nm47/blup/CAD/reference/blup-pcb-completed.step

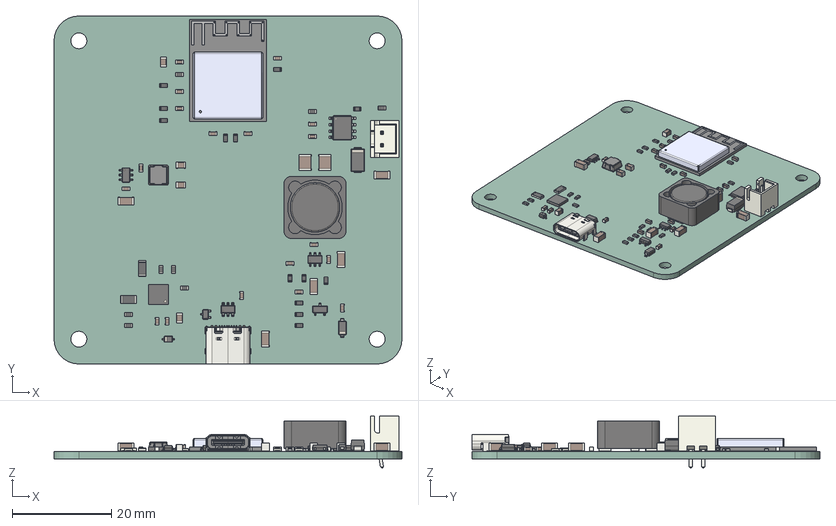
[picture p1: CAD file, 2026-09-09]
CAD/reference/blup-pcb-completed.step
70.0 x 70.0 x 10.4 mm
R_0603_1608Metric x 21
C_0603_1608Metric x 18
C_0805_2012Metric x 4
ESP32-S3-MINI-1-N8
D_SOD-123
TSOT-23-6 x 2
C_1210_3225Metric x 2
R_1206_3216Metric x 2
C_1206_3216Metric x 5
TI_SO-PowerPAD-8
D_SMA
SOT-23
JST_B2B_XH_A
SOT-23-6
QFN-24-1EP_4x4mm_P0.5mm_EP2.7x2.7mm
D_SOD-323
USB_C_Receptacle_16P_TopMnt_Horizontal_GCT_USB4105-xx-A
SOT-323_SC-70
SRR1260
L_Bourns-SRN4018
blÃ¼p_PCB
