nm47/blup/CAD/baselines/before_valve_import_20260908_104825.FCStd

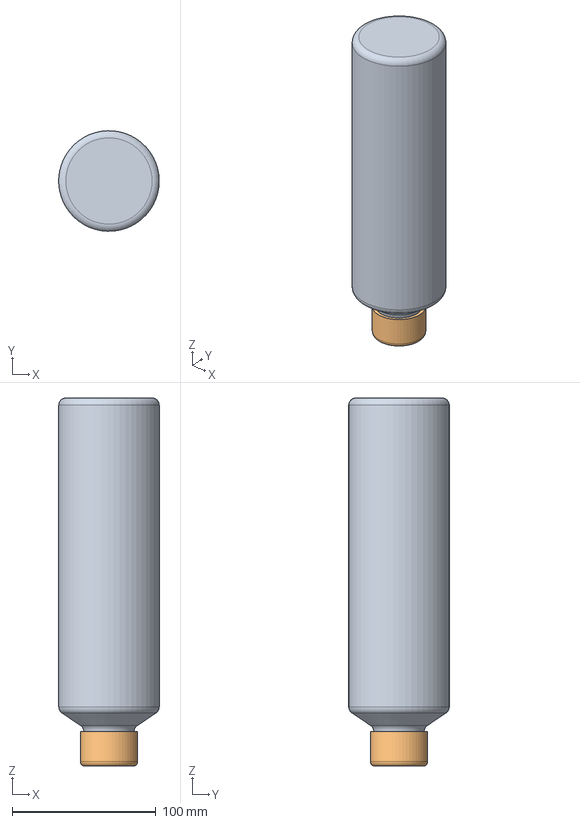
[picture p2: CAD file, 2026-09-08]
CAD/baselines/before_valve_import_20260908_104825.FCStd
69.9 x 70.0 x 256.0 mm
Bottle
Cap
