nm47/blup/CAD/blüp.FCStd

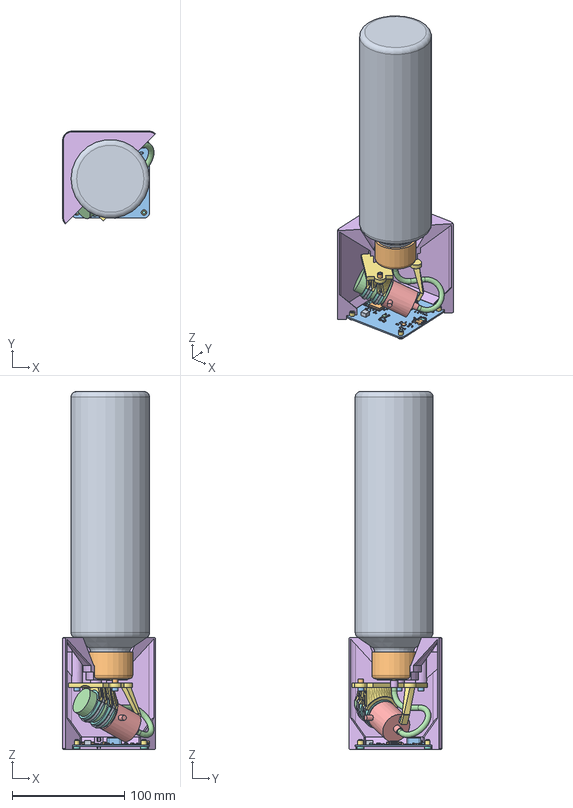
[picture p3: CAD file, 2026-09-09]
CAD/blüp.FCStd
82.7 x 82.7 x 319.0 mm
Bottle
Cap
O-ring 26x34x4 (squeezed, visual)
Valve retaining ring — wrench flats v2
Valve O-ring — 10 mm ID x 2 mm CS (compressed)
47245K115 — housing part 1
47245K115 — housing part 2
R_0603_1608Metric042
C_0603_1608Metric036
C_0603_1608Metric038
R_0603_1608Metric044
C_0805_2012Metric008
C_0805_2012Metric010
C_0603_1608Metric040
ESP32-S3-MINI-1-N100
ESP32-S3-MINI-1-N101
ESP32-S3-MINI-1-N102
ESP32-S3-MINI-1-N103
ESP32-S3-MINI-1-N104
ESP32-S3-MINI-1-N105
ESP32-S3-MINI-1-N106
ESP32-S3-MINI-1-N107
ESP32-S3-MINI-1-N108
ESP32-S3-MINI-1-N109
ESP32-S3-MINI-1-N110
ESP32-S3-MINI-1-N111
ESP32-S3-MINI-1-N112
ESP32-S3-MINI-1-N113
ESP32-S3-MINI-1-N114
ESP32-S3-MINI-1-N115
ESP32-S3-MINI-1-N116
ESP32-S3-MINI-1-N117
ESP32-S3-MINI-1-N118
ESP32-S3-MINI-1-N119
ESP32-S3-MINI-1-N120
ESP32-S3-MINI-1-N121
ESP32-S3-MINI-1-N122
ESP32-S3-MINI-1-N123
ESP32-S3-MINI-1-N124
ESP32-S3-MINI-1-N125
ESP32-S3-MINI-1-N126
ESP32-S3-MINI-1-N127
ESP32-S3-MINI-1-N128
ESP32-S3-MINI-1-N129
ESP32-S3-MINI-1-N130
ESP32-S3-MINI-1-N131
ESP32-S3-MINI-1-N132
ESP32-S3-MINI-1-N133
ESP32-S3-MINI-1-N134
ESP32-S3-MINI-1-N135
ESP32-S3-MINI-1-N136
ESP32-S3-MINI-1-N137
ESP32-S3-MINI-1-N138
ESP32-S3-MINI-1-N139
ESP32-S3-MINI-1-N140
ESP32-S3-MINI-1-N141
ESP32-S3-MINI-1-N142
ESP32-S3-MINI-1-N143
ESP32-S3-MINI-1-N144
ESP32-S3-MINI-1-N145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
