nm47/blup/CAD/baselines/before_interior_valve_trial_20260908_110144.FCStd

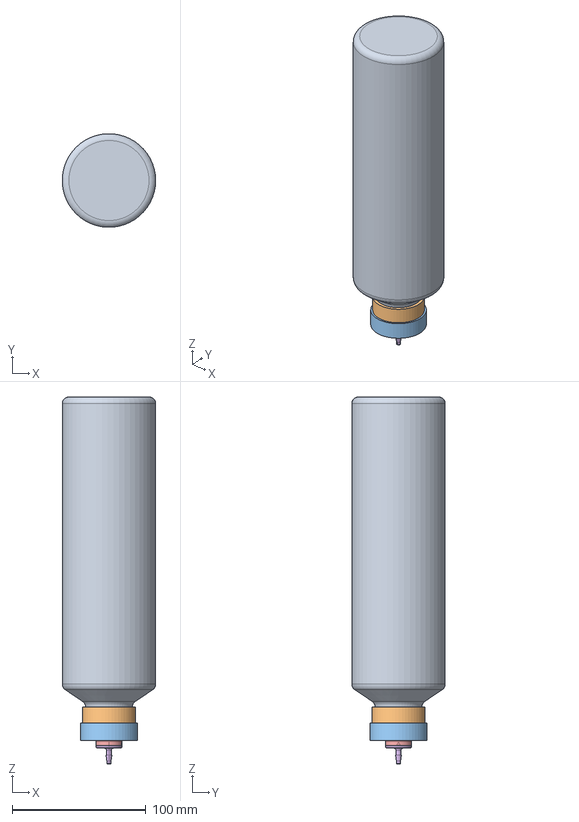
[picture p5: CAD file, 2026-09-08]
CAD/baselines/before_interior_valve_trial_20260908_110144.FCStd
69.9 x 70.0 x 274.7 mm
Bottle
Cap
Collar
O-ring 26x34x4 (squeezed, visual)
47245K115 — housing part 1
47245K115 — housing part 2
