nm47/blup/CAD/prints/thread_test_ring_p3.3_t1.75_rad0.3_ax0.5.stl

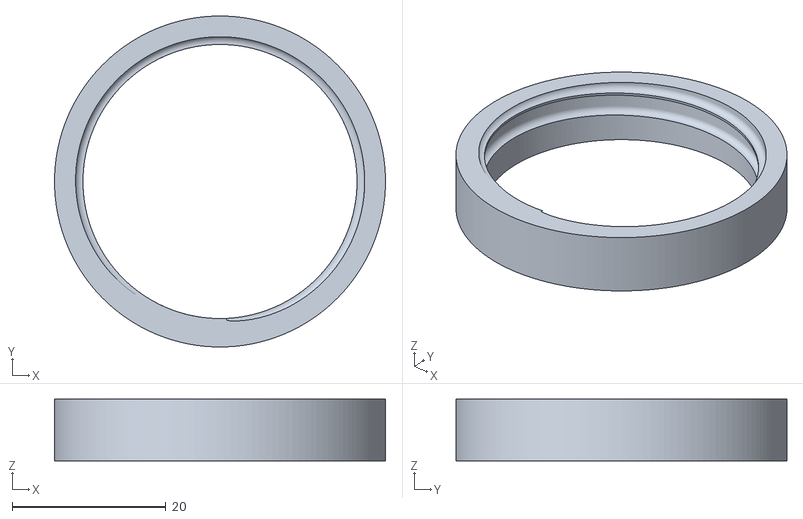
[picture p6: CAD file, 2026-09-08]
CAD/prints/thread_test_ring_p3.3_t1.75_rad0.3_ax0.5.stl
43.0 x 43.0 x 8.00
