nm47/blup/CAD/baselines/before_valve_face_trial_20260908_105313.FCStd

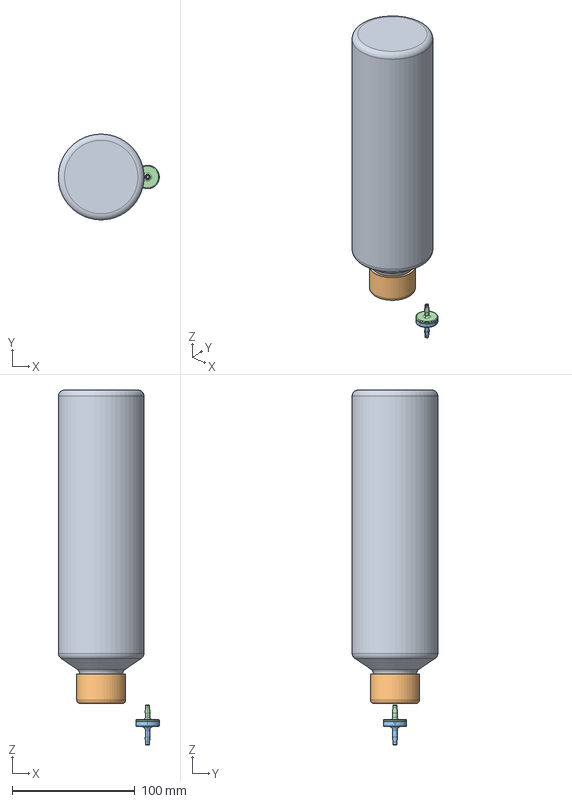
[picture p7: CAD file, 2026-09-08]
CAD/baselines/before_valve_face_trial_20260908_105313.FCStd
82.6 x 70.0 x 289.8 mm
Bottle
Cap
47245K115 — housing part 1
47245K115 — housing part 2
