nm47/blup/CAD/prints/thread_test_ring_p3.5_w2.5_r1.0_rad0.3_ax0.2_relief2.stl

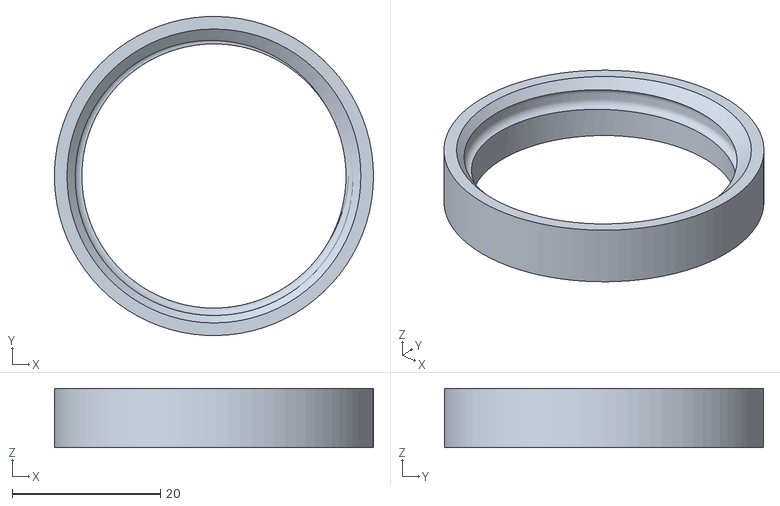
[picture p8: CAD file, 2026-09-08]
CAD/prints/thread_test_ring_p3.5_w2.5_r1.0_rad0.3_ax0.2_relief2.stl
43.0 x 43.0 x 8.00
