nm47/blup/CAD/prints/collar_face_stop_gap2_relief2.stl

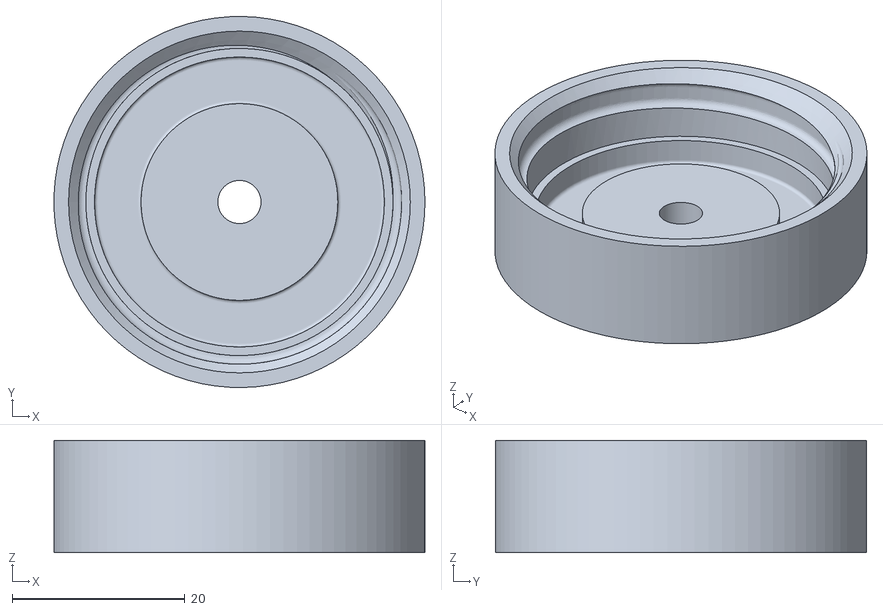
[picture p10: CAD file, 2026-09-08]
CAD/prints/collar_face_stop_gap2_relief2.stl
43.0 x 43.0 x 13.0
