nm47/blup/CAD/prints/collar_p3.5_w2.5_r1.0_rad0.3_ax0.2_relief2.stl

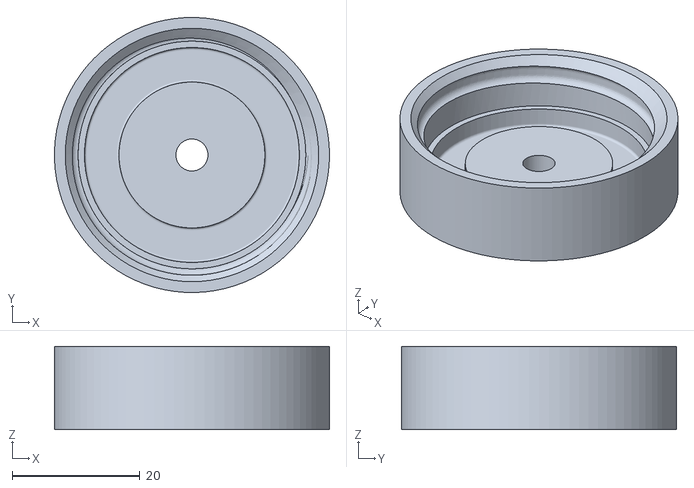
[picture p11: CAD file, 2026-09-08]
CAD/prints/collar_p3.5_w2.5_r1.0_rad0.3_ax0.2_relief2.stl
43.0 x 43.0 x 13.0
