nm47/blup/(list of files, cad)

Other CAD files:
CAD/baselines/cap_fit_oring_pass_20260907.FCStd
CAD/prints/thread_test_ring_p3.5_w2.5_s2.2_r1.0_rad0.3_ax0.2_relief2.stl
CAD/prints/thread_test_ring_p3.5_t1.75_rad0.4_ax0.7.stl
CAD/prints/collar_p3.5_w2.5_s2.2_r1.0_rad0.3_ax0.2_relief2.stl
CAD/prints/print_me.stl
CAD/prints/thread_test_ring_p3.5_t1.75_rad0.2_ax0.3.stl
CAD/prints/thread_test_ring_p3.5_t1.75_rad0.3_ax0.5.stl
CAD/prints/thread_test_ring_p3.7_t1.75_rad0.3_ax0.5.stl
CAD/47245K115_Check Valve.STEP
CAD/backups/blüp-before-cap-lip-fit-20260907-204544.FCStd
CAD/backups/blüp-before-deep-thread-extension-20260907-223648.FCStd
CAD/backups/blüp-before-face-stop-relief-20260907-210121.FCStd
CAD/backups/blüp-before-measured-thread-profile-20260907-215647.FCStd
CAD/backups/blüp-before-thread-2p125-turns-20260907-221232.FCStd
CAD/backups/blüp-before-thread-offset-2p2-20260907-220202.FCStd
CAD/backups/blüp-before-two-turn-bottle-thread-20260907-220707.FCStd
