nm47/blup/hardware/blüp/blüp.kicad_pcb

## KiCad design hardware/blüp/blüp.kicad_pcb (2026-09-09)

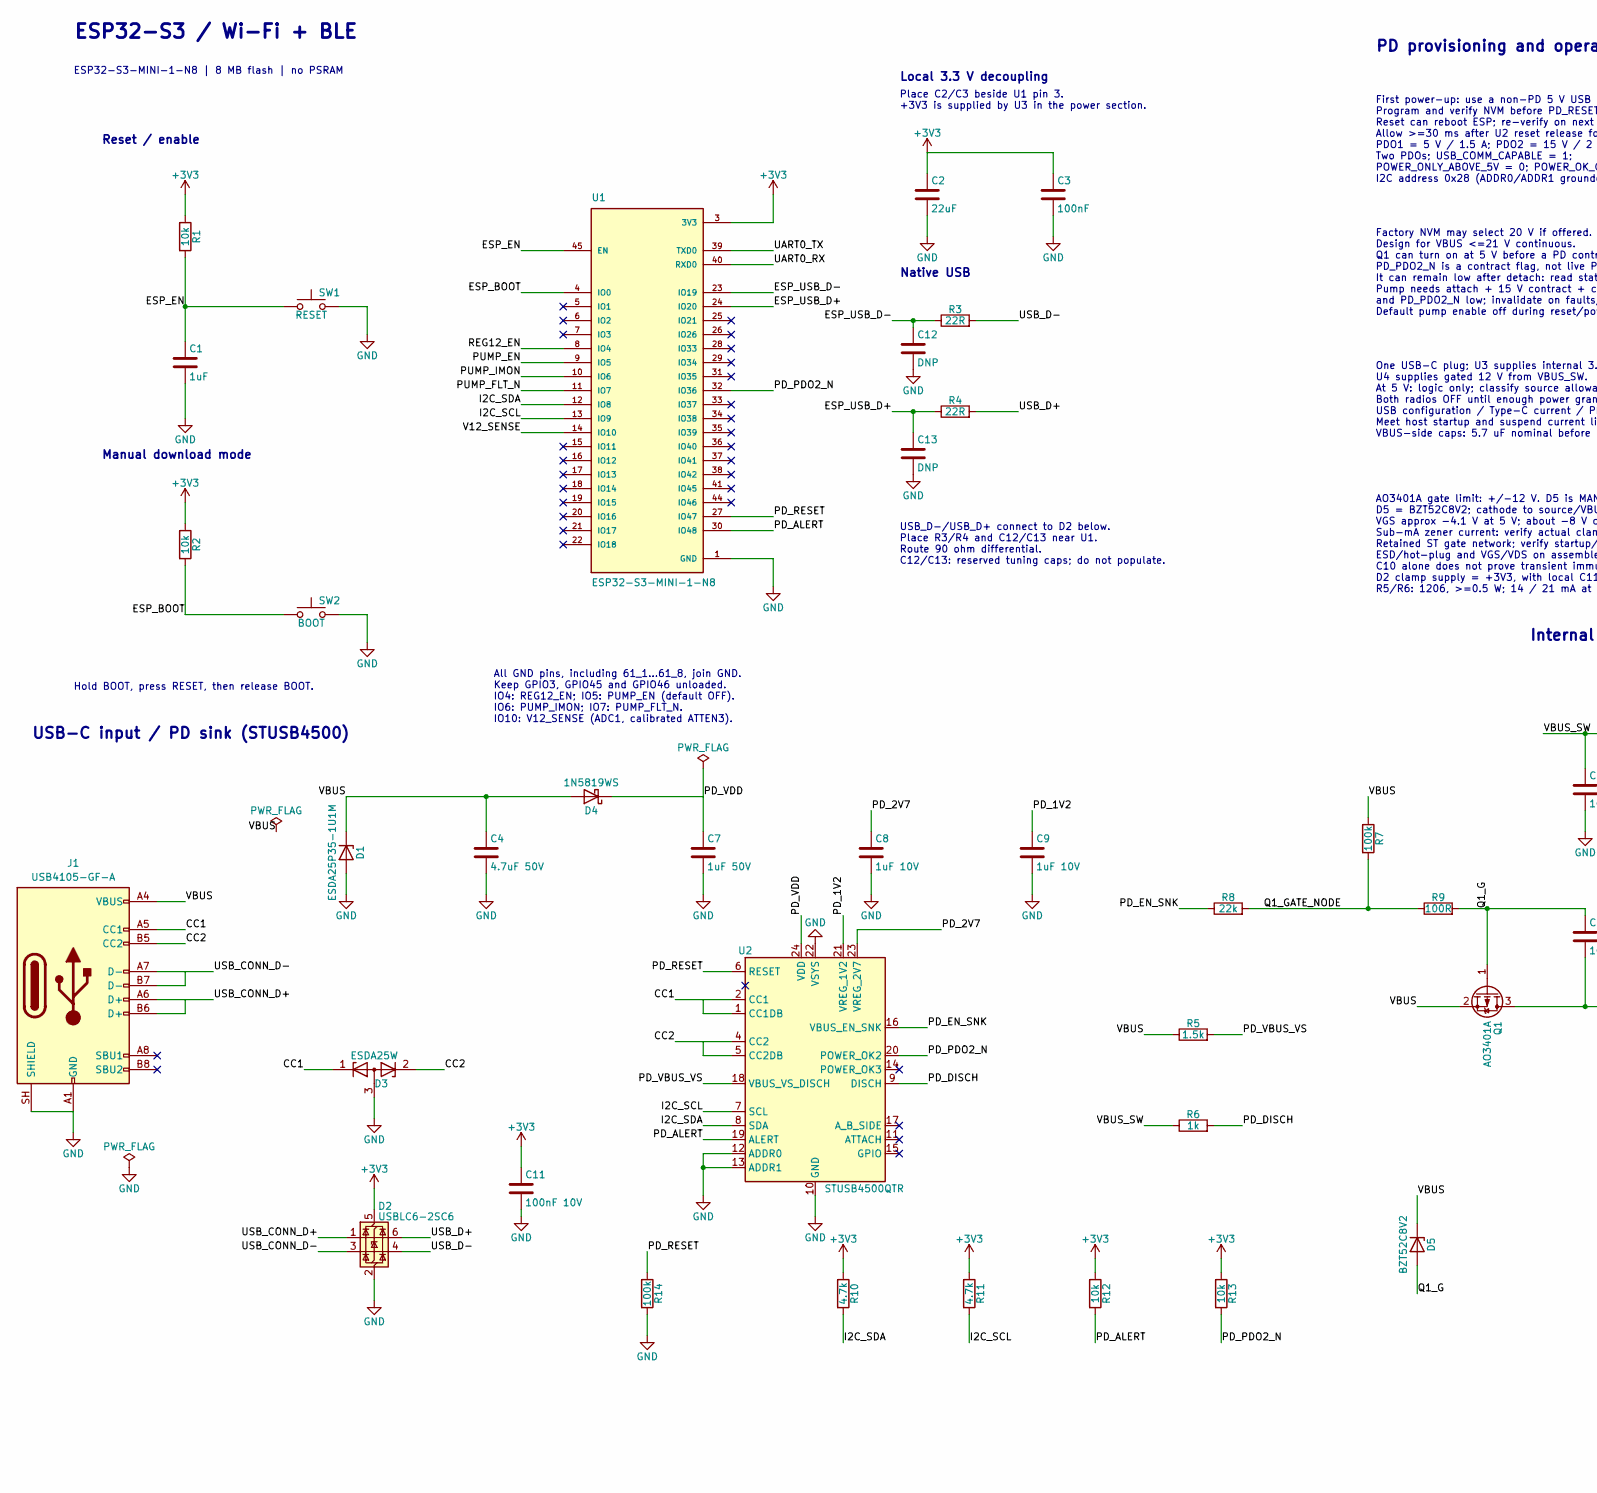
[picture p12: schematic blüp.kicad_sch, part in row 1, column 1]

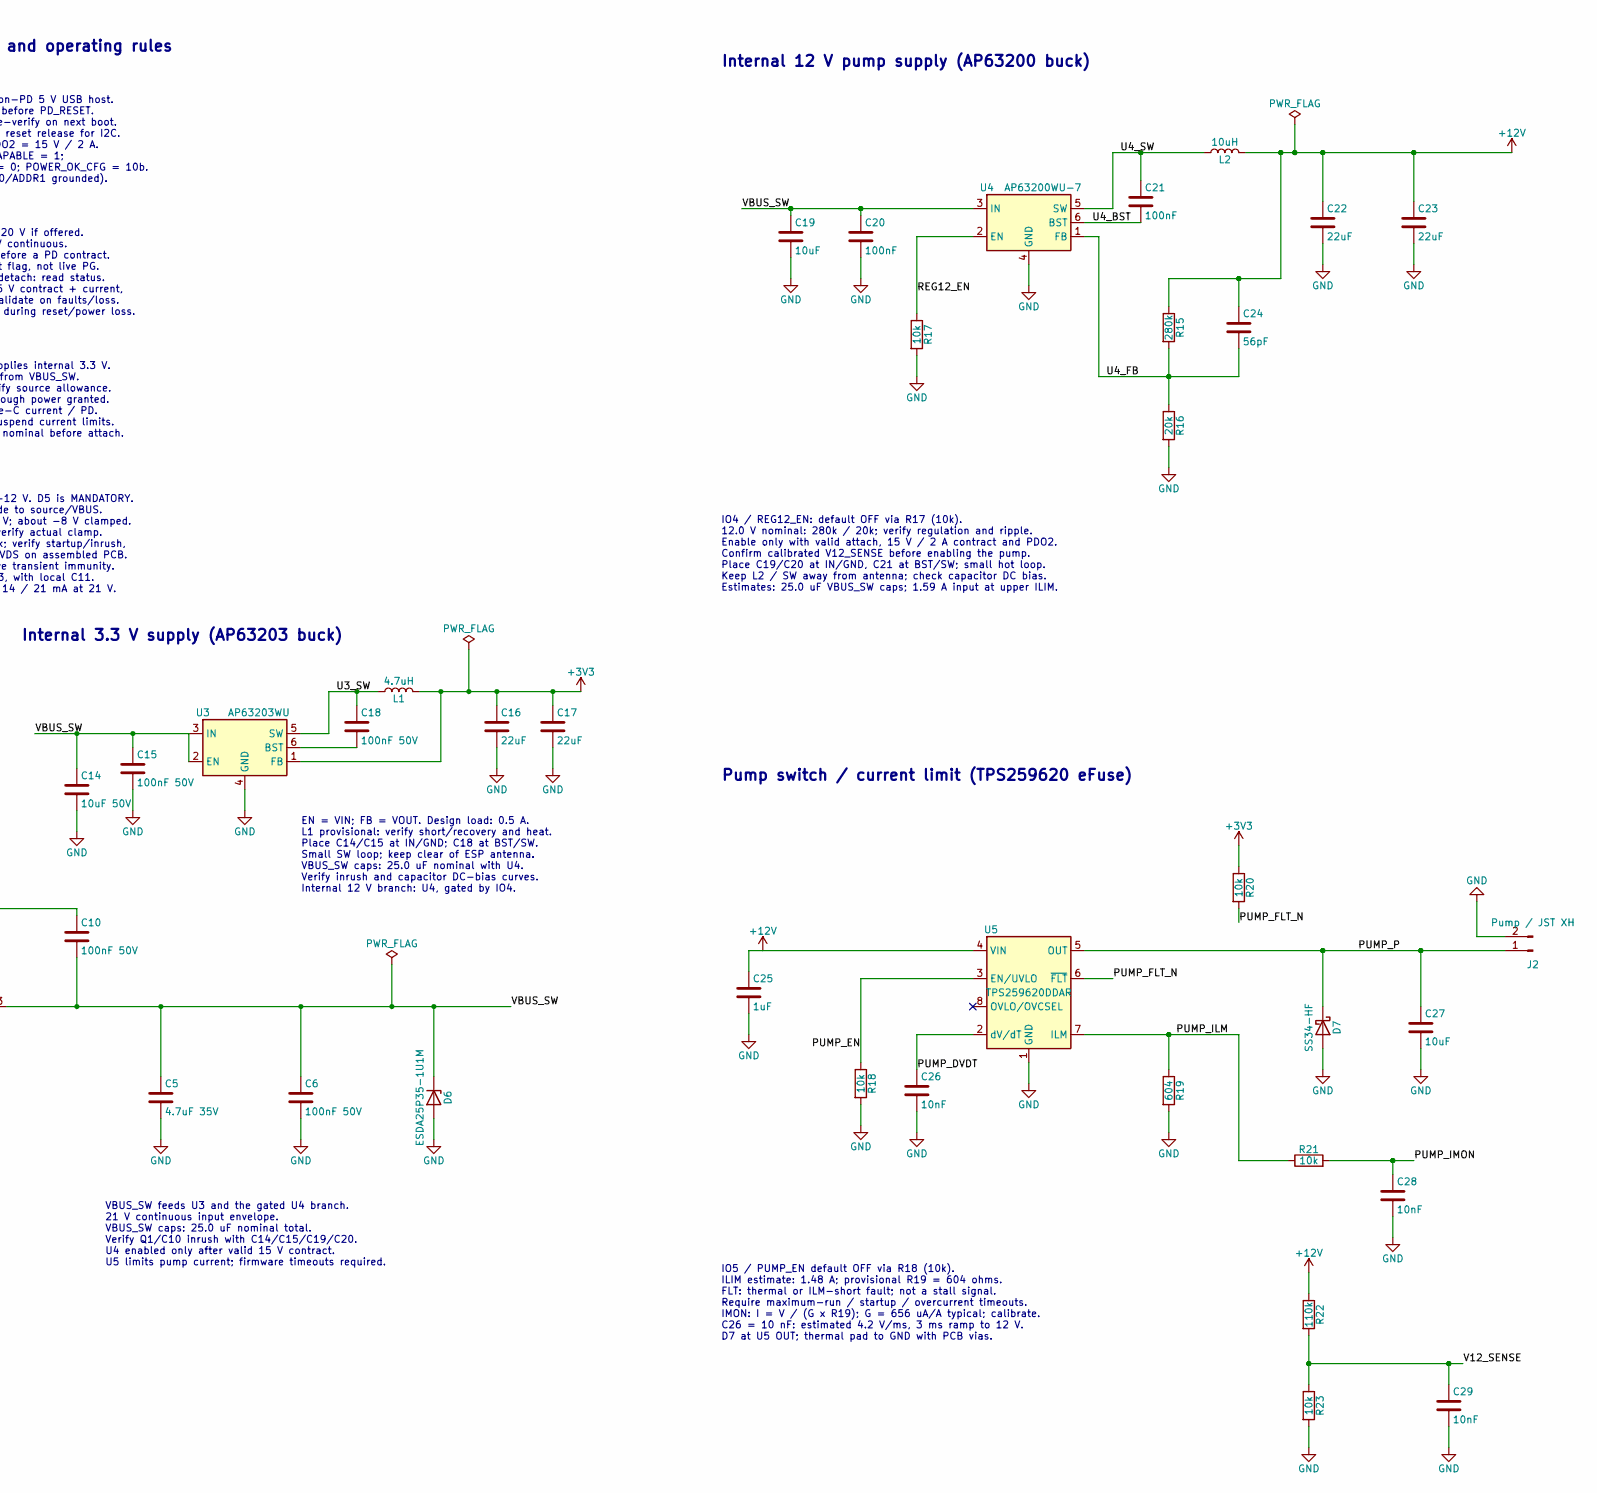
[picture p13: schematic blüp.kicad_sch, part in row 1, column 2]

Parts:
C1: 1uF; C_0603_1608Metric; Tolerance 10%; Voltage 10V
C2, C16, C17: 22uF; C_0805_2012Metric; Tolerance 10%; Voltage 10V
C3: 100nF; C_0603_1608Metric; Tolerance 10%; Voltage 10V
C4: 4.7uF 50V; C_1206_3216Metric; Tolerance 10%; Voltage 50V
C5: 4.7uF 35V; C_1206_3216Metric; Tolerance 10%; Voltage 35V
C6, C10, C15, C18: 100nF 50V; C_0603_1608Metric; Tolerance 10%; Voltage 50V
C7: 1uF 50V; C_0805_2012Metric; Tolerance 10%; Voltage 50V
C8, C9: 1uF 10V; C_0603_1608Metric; Tolerance 10%; Voltage 10V
C11: 100nF 10V; C_0603_1608Metric; Tolerance 10%; Voltage 10V
C12, C13: DNP; C_0603_1608Metric
C14: 10uF 50V; C_1206_3216Metric; Tolerance 10%; Voltage 50V
C19: 10uF; C_1206_3216Metric; Tolerance 10%; Voltage 50V
C20, C21: 100nF; C_0603_1608Metric; Tolerance 10%; Voltage 50V
C22, C23: 22uF; C_1210_3225Metric; Tolerance 10%; Voltage 25V
C24: 56pF; C_0603_1608Metric; Tolerance 5%; Voltage 50V
C25: 1uF; C_0603_1608Metric; Tolerance 10%; Voltage 25V
C26, C28, C29: 10nF; C_0603_1608Metric; Tolerance 10%; Voltage 16V
C27: 10uF; C_1206_3216Metric; Tolerance 10%; Voltage 25V
D1, D6: ESDA25P35-1U1M; ST_QFN-2L_1.6x1.0mm; MPN ESDA25P35-1U1M; LCSC C1974707
D2: USBLC6-2SC6; SOT-23-6; MPN USBLC6-2SC6; LCSC C7519
D3: ESDA25W; SOT-323_SC-70; MPN ESDA25W; LCSC C2935152
D4: 1N5819WS; D_SOD-323; MPN 1N5819WS; LCSC C1884554
D5: BZT52C8V2; D_SOD-123; MPN BZT52C8V2-7-F
D7: SS34-HF; D_SMA; MPN SS34-HF
J1: USB4105-GF-A; USB_C_Receptacle_GCT_USB4105-xx-A_16P_TopMnt_Horizontal; MPN USB4105-GF-A
J2: Pump / JST XH; JST_XH_B2B-XH-A_1x02_P2.50mm_Vertical; MPN B2B-XH-A(LF)(SN)
L1: 4.7uH; L_Bourns-SRN4018; Tolerance 20%; MPN SRN4018-4R7M; LCSC C780206
L2: 10uH; L_Bourns_SRR1260; Tolerance 20%; MPN SRR1260-100M
Q1: AO3401A; SOT-23; MPN AO3401A; LCSC C15127
R1, R2: 10k; R_0603_1608Metric
R3, R4: 22R; R_0603_1608Metric
R5: 1.5k; R_1206_3216Metric; Tolerance 1%
R6: 1k; R_1206_3216Metric; Tolerance 1%
R7, R14: 100k; R_0603_1608Metric; Tolerance 1%
R8: 22k; R_0603_1608Metric; Tolerance 1%
R9: 100R; R_0603_1608Metric; Tolerance 1%
R10, R11: 4.7k; R_0603_1608Metric; Tolerance 1%
R12, R13, R17, R18, R20, R21, R23: 10k; R_0603_1608Metric; Tolerance 1%
R15: 280k; R_0603_1608Metric; Tolerance 1%
R16: 20k; R_0603_1608Metric; Tolerance 1%
R19: 604; R_0603_1608Metric; Tolerance 1%
R22: 110k; R_0603_1608Metric; Tolerance 1%
SW1: RESET; SW_Push_1P1T_XKB_TS-1187A; MPN TS-1187A-B-A-B; LCSC C318884
SW2: BOOT; SW_Push_1P1T_XKB_TS-1187A; MPN TS-1187A-B-A-B; LCSC C318884
U1: ESP32-S3-MINI-1-N8; XCVR_ESP32-S3-MINI-1-N8; MPN ESP32-S3-MINI-1-N8
U2: STUSB4500QTR; QFN-24-1EP_4x4mm_P0.5mm_EP2.7x2.7mm; MPN STUSB4500QTR; LCSC C2678061
U3: AP63203WU; TSOT-23-6; MPN AP63203WU-7; LCSC C780769
U4: AP63200WU-7; TSOT-23-6; MPN AP63200WU-7
U5: TPS259620DDAR; TI_SO-PowerPAD-8; MPN TPS259620DDAR

Connections:
+3V3: C2.1, C3.1, C11.1, C16.1, C17.1, D2.5 (VBUS), L1.2, R1.1, R2.1, R10.1, R11.1, R12.1, R13.1, R20.1, U1.3 (3V3), U3.1 (FB)
+12V: C22.1, C23.1, C24.1, C25.1, L2.2, R15.1, R22.1, U5.4 (VIN)
/CC1: D3.1 (K), J1.A5 (CC1), U2.1 (CC1DB), U2.2 (CC1)
/CC2: D3.2 (K), J1.B5 (CC2), U2.4 (CC2), U2.5 (CC2DB)
/ESP_BOOT: R2.2, SW2.1, U1.4 (IO0)
/ESP_EN: C1.1, R1.2, SW1.1, U1.45 (EN)
/ESP_USB_D+: C13.1, R4.1, U1.24 (IO20)
/ESP_USB_D-: C12.1, R3.1, U1.23 (IO19)
/I2C_SCL: R11.2, U1.13 (IO9), U2.7 (SCL)
/I2C_SDA: R10.2, U1.12 (IO8), U2.8 (SDA)
/PD_1V2: C9.1, U2.21 (VREG_1V2)
/PD_2V7: C8.1, U2.23 (VREG_2V7)
/PD_ALERT: R12.2, U1.30 (IO48), U2.19 (ALERT)
/PD_DISCH: R6.2, U2.9 (DISCH)
/PD_EN_SNK: R8.1, U2.16 (VBUS_EN_SNK)
/PD_PDO2_N: R13.2, U1.32 (IO36), U2.20 (POWER_OK2)
/PD_RESET: R14.1, U1.27 (IO47), U2.6 (RESET)
/PD_VBUS_VS: R5.2, U2.18 (VBUS_VS_DISCH)
/PD_VDD: C7.1, D4.1 (K), U2.24 (VDD)
/PUMP_DVDT: C26.1, U5.2 (dV/dT)
/PUMP_EN: R18.1, U1.9 (IO5), U5.3 (EN/UVLO)
/PUMP_FLT_N: R20.2, U1.11 (IO7), U5.6 (~FLT)
/PUMP_ILM: R19.1, R21.1, U5.7 (ILM)
/PUMP_IMON: C28.1, R21.2, U1.10 (IO6)
/PUMP_P: C27.1, D7.1 (K), J2.1, U5.5 (OUT)
/Q1_G: C10.1, D5.2 (A), Q1.1 (G), R9.2
/Q1_GATE_NODE: R7.2, R8.2, R9.1
/REG12_EN: R17.1, U1.8 (IO4), U4.2 (EN)
/U3_SW: C18.1, L1.1, U3.5 (SW)
/U4_BST: C21.2, U4.6 (BST)
/U4_FB: C24.2, R15.2, R16.1, U4.1 (FB)
/U4_SW: C21.1, L2.1, U4.5 (SW)
/UART0_RX: U1.40 (RXD0)
/UART0_TX: U1.39 (TXD0)
/USB_CONN_D+: D2.1 (I/O1), J1.A6 (D+), J1.B6 (D+)
/USB_CONN_D-: D2.3 (I/O2), J1.A7 (D-), J1.B7 (D-)
/USB_D+: D2.6 (I/O1), R4.2
/USB_D-: D2.4 (I/O2), R3.2
/V12_SENSE: C29.1, R22.2, R23.1, U1.14 (IO10)
/VBUS: C4.1, D1.1 (K), D4.2 (A), D5.1 (K), J1.A4 (VBUS), J1.A9 (VBUS), J1.B4 (VBUS), J1.B9 (VBUS), Q1.2 (S), R5.1, R7.1
/VBUS_SW: C5.1, C6.1, C10.2, C14.1, C15.1, C19.1, C20.1, D6.1 (K), Q1.3 (D), R6.1, U3.2 (EN), U3.3 (IN), U4.3 (IN)
GND: C1.2, C2.2, C3.2, C4.2, C5.2, C6.2, C7.2, C8.2, C9.2, C11.2, C12.2, C13.2, C14.2, C15.2, C16.2, C17.2, C19.2, C20.2, C22.2, C23.2, C25.2, C26.2, C27.2, C28.2, C29.2, D1.2 (A), D2.2 (GND), D3.3 (A), D6.2 (A), D7.2 (A), J1.A1 (GND), J1.A12 (GND), J1.B1 (GND), J1.B12 (GND), J1.SH (SHIELD), J2.2, R14.2, R16.2, R17.2, R18.2, R19.2, R23.2, SW1.2, SW2.2, U1.1 (GND), U1.2 (GND), U1.42 (GND), U1.43 (GND), U1.46 (GND), U1.47 (GND), U1.48 (GND), U1.49 (GND), U1.50 (GND), U1.51 (GND), U1.52 (GND), U1.53 (GND), U1.54 (GND), U1.55 (GND), U1.56 (GND), U1.57 (GND), U1.58 (GND), U1.59 (GND), U1.60 (GND), U1.61 (GND), U1.61_1 (GND), U1.61_2 (GND), U1.61_3 (GND), U1.61_4 (GND), U1.61_5 (GND), U1.61_6 (GND), U1.61_7 (GND), U1.61_8 (GND), U1.62 (GND), U1.63 (GND), U1.64 (GND), U1.65 (GND), U2.10 (GND), U2.12 (ADDR0), U2.13 (ADDR1), U2.22 (VSYS), U2.25 (GND), U3.4 (GND), U4.4 (GND), U5.1 (GND), U5.9 (GND)
unnamed: C18.2, U3.6 (BST)

Notes on the sheet:
Local 3.3 V decoupling
ESP32-S3-MINI-1-N8 | 8 MB flash | no PSRAM
Reset / enable
ESP32-S3 / Wi-Fi + BLE
Native USB
Manual download mode
Hold BOOT, press RESET, then release BOOT.
PD provisioning and operating rules
USB-C input / PD sink (STUSB4500)
USB_D-/USB_D+ connect to D2 below. Place R3/R4 and C12/C13 near U1. Route 90 ohm differential. C12/C13: reserved tuning caps; do not populate.
First power-up: use a non-PD 5 V USB host. Program and verify NVM before PD_RESET. Reset can reboot ESP; re-verify on next boot. Allow >=30 ms after U2 reset release for I2C. PDO1 = 5 V / 1.5 A; PDO2 = 15 V / 2 A. Two PDOs; USB_COMM_CAPABLE = 1; POWER_ONLY_ABOVE_5V = 0; POWER_OK_CFG = 10b. I2C addr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
Factory NVM may select 20 V if offered. Design for VBUS <=21 V continuous. Q1 can turn on at 5 V before a PD contract. PD_PDO2_N is a contract flag, not live PG. It can remain low after detach: read status. Pump needs attach + 15 V contract + current, and PD_PDO2_N low; invalidate on faults/loss. D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
AO3401A gate limit: +/-12 V. D5 is MANDATORY. D5 = BZT52C8V2; cathode to source/VBUS. VGS approx -4.1 V at 5 V; about -8 V clamped. Sub-mA zener current: verify actual clamp. Retained ST gate network; verify startup/inrush, ESD/hot-plug and VGS/VDS on assembled PCB. C10 alone does not prove transie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
Internal 3.3 V supply (AP63203 buck)
Place C2/C3 beside U1 pin 3. +3V3 is supplied by U3 in the power section.
All GND pins, including 61_1...61_8, join GND. Keep GPIO3, GPIO45 and GPIO46 unloaded. IO4: REG12_EN; IO5: PUMP_EN (default OFF). IO6: PUMP_IMON; IO7: PUMP_FLT_N. IO10: V12_SENSE (ADC1, calibrated ATTEN3).
EN = VIN; FB = VOUT. Design load: 0.5 A. L1 provisional: verify short/recovery and heat. Place C14/C15 at IN/GND; C18 at BST/SW. Small SW loop; keep clear of ESP antenna. VBUS_SW caps: 25.0 uF nominal with U4. Verify inrush and capacitor DC-bias curves. Internal 12 V branch: U4, gated by IO4.
One USB-C plug; U3 supplies internal 3.3 V. U4 supplies gated 12 V from VBUS_SW. At 5 V: logic only; classify source allowance. Both radios OFF until enough power granted. USB configuration / Type-C current / PD. Meet host startup and suspend current limits. VBUS-side caps: 5.7 uF nominal before at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
VBUS_SW feeds U3 and the gated U4 branch. 21 V continuous input envelope. VBUS_SW caps: 25.0 uF nominal total. Verify Q1/C10 inrush with C14/C15/C19/C20. U4 enabled only after valid 15 V contract. U5 limits pump current; firmware timeouts required.
Internal 12 V pump supply (AP63200 buck)
IO4 / REG12_EN: default OFF via R17 (10k). 12.0 V nominal: 280k / 20k; verify regulation and ripple. Enable only with valid attach, 15 V / 2 A contract and PDO2. Confirm calibrated V12_SENSE before enabling the pump. Place C19/C20 at IN/GND, C21 at BST/SW; small hot loop. Keep L2 / SW away from ant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
Pump switch / current limit (TPS259620 eFuse)
IO5 / PUMP_EN default OFF via R18 (10k). ILIM estimate: 1.48 A; provisional R19 = 604 ohms. FLT: thermal or ILM-short fault; not a stall signal. Require maximum-run / startup / overcurrent timeouts. IMON: I = V / (G x R19); G = 656 uA/A typical; calibrate. C26 = 10 nF: estimated 4.2 V/ms, 3 ms ramp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

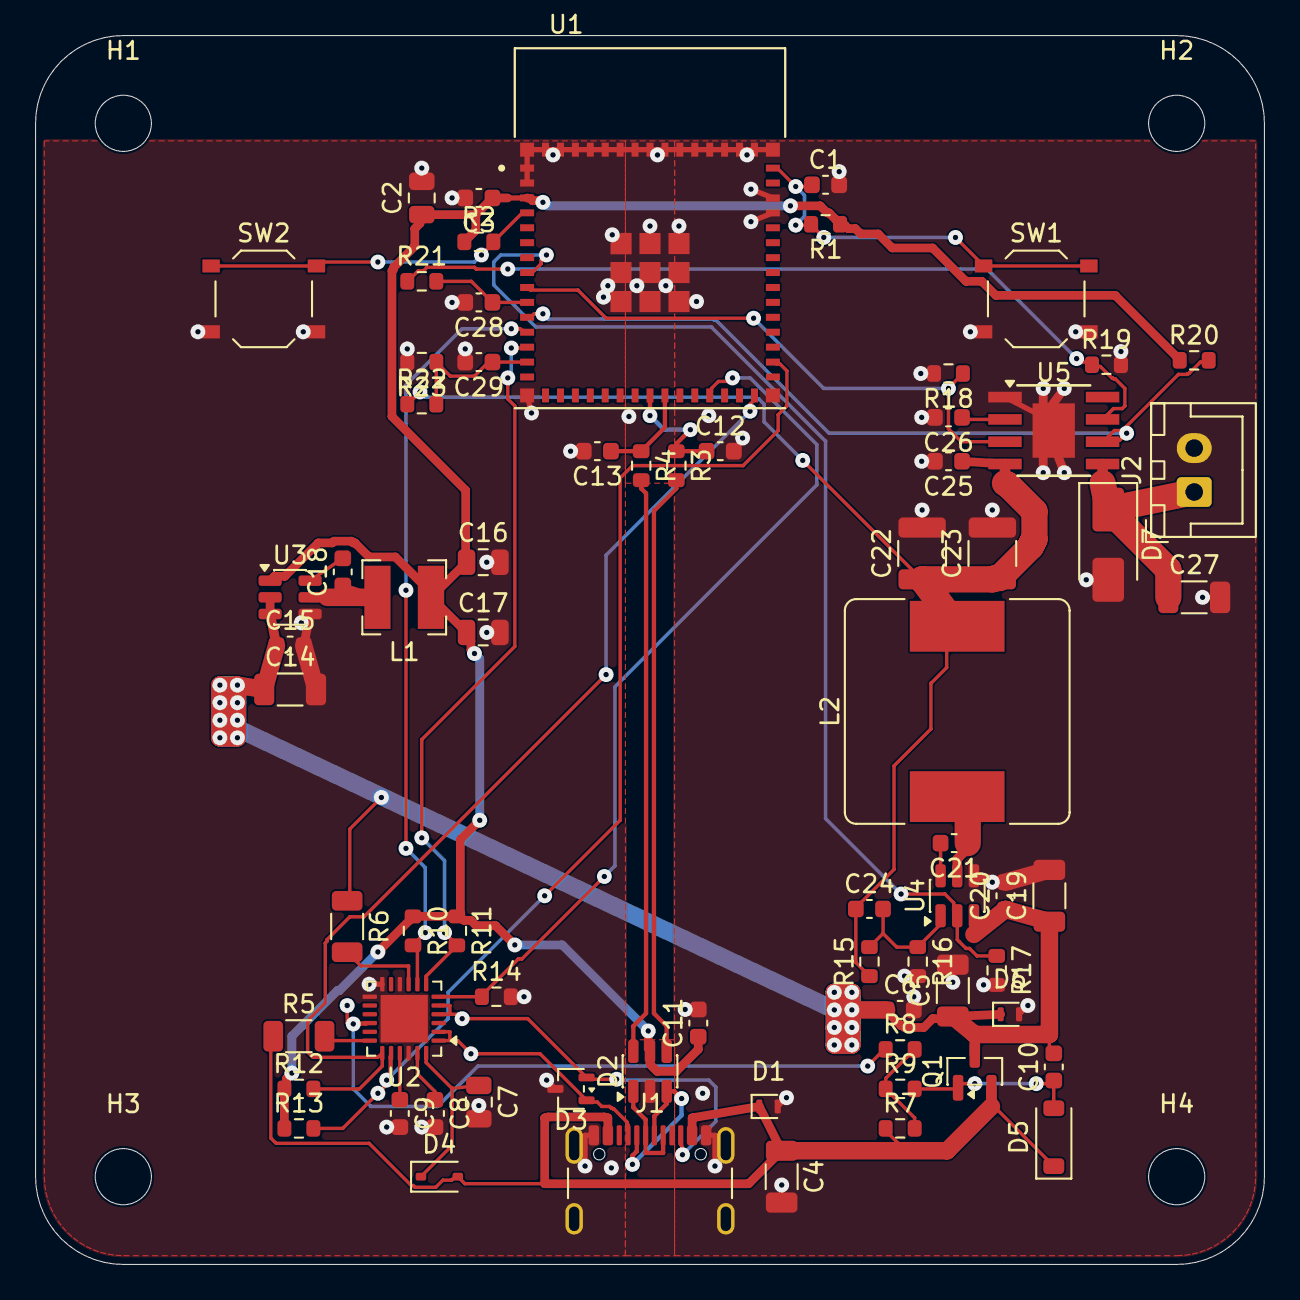
[picture p14: board blüp.kicad_pcb from above]

Board: 4 copper layers, 70.0 x 70.0 mm, 75 parts (0 on the bottom side), 41 nets.

Other parts of the board:
H1, H2, H3, H4: MountingHole_3.2mm_M3
