nm47/blup/(commit log)

2026-09-08 Save working cap and interior check-valve placement
    [47245K115_Check Valve.STEP, before_interior_valve_trial_20260908_110144.FCStd, before_valve_face_trial_20260908_105313.FCStd, before_valve_import_20260908_104825.FCStd, blüp-before-cap-lip-fit-20260907-204544.FCStd, blüp-before-deep-thread-extension-20260907-223648.FCStd, blüp-before-face-stop-relief-20260907-210121.FCStd, blüp-before-measured-thread-profile-20260907-215647.FCStd]
2026-09-09 first cut CAD + PCB
    [blup-pcb-completed.step, blüp.FCStd, blüp.kicad_pcb]
